kobush/AirCasting/README.md

AirCasting
==========

AirCasting project
