kobush/AirCasting/Docs/IMG_14012013_202546.png

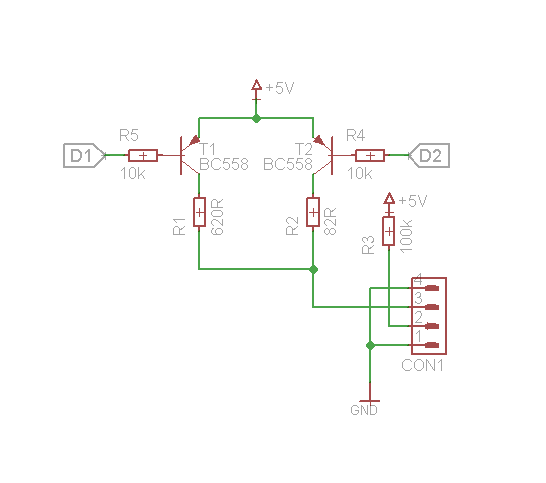
Docs/IMG_14012013_202546.png
