kobush/AirCasting/(list of files, cad)

Other CAD files:
Docs/ProtoCas1.skp
