kobush/AirCasting/(commit log)

2013-03-13 Adds current sketches
2013-03-13 Adds docs
    [ProtoCas1.skp]
2013-03-13 Updated temp sensor test
